ka23187/STM32F103C8T6Car/原理图等文档/原理图等文档/编码电机工作原理.pdf

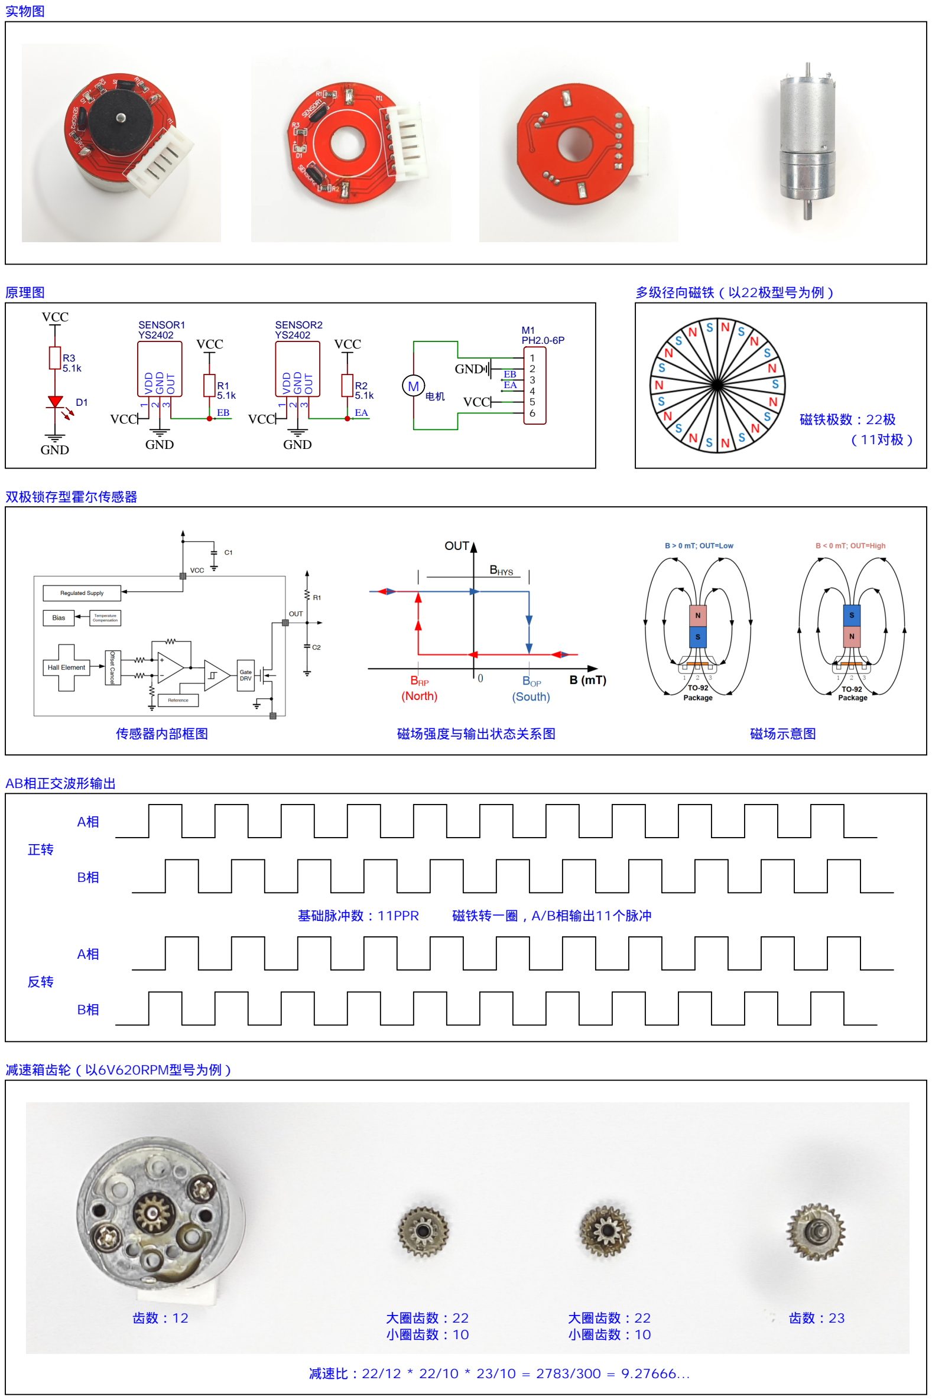
[picture p1: page 1]

PH2.0-6P

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
GND EB EA

YS2402

SENSOR1 VDD

1

GND

2

OUT

3

YS2402

SENSOR2 VDD

1

GND

2

OUT

3

5.1k

R1
5.1k

R2

5.1k

R3

D1

VCC

GND | GND | GND
VCC | VCC

VCC

EB | EA

VCC

传感器内部框图 | 磁场强度与输出状态关系图 | 磁场示意图

双极锁存型霍尔传感器

原理图 | 多级径向磁铁（以22极型号为例）

实物图

基础脉冲数：11PPR

磁铁极数：22极

A相

B相

正转

反转
B相

A相

AB相正交波形输出

磁铁转一圈，A/B相输出11个脉冲

（11对极）

减速箱齿轮（以6V620RPM型号为例）

齿数：12 | 大圈齿数：22 小圈齿数：10

大圈齿数：22
小圈齿数：10

齿数：23

减速比：22/12 * 22/10 * 23/10 = 2783/300 = 9.27666...
