ka23187/STM32F103C8T6Car/原理图等文档/原理图等文档/原理图版本说明.txt

************************************************************
平衡车控制板-V1.0
- 初始版本

平衡车控制板-V2.0
- 将单独LDO降压结构改成了DCDC+LDO串联降压结构，降低了LDO的发热

************************************************************
遥控器-V1.0
- 初始版本

遥控器-V2.0
- 增加了电源指示灯，方便观察电源状态

遥控器-V3.0
- TypeC接口增加了两个5.1kΩ电阻，支持双C口电源线充电
- 优化了天线匹配电路，信号更好
