ka23187/STM32F103C8T6Car/原理图等文档/原理图等文档/遥控器-V1.0.pdf

# ANT 10 GND 11 GND 12 DNC 13 VDD 14 GND 15 VCC 16

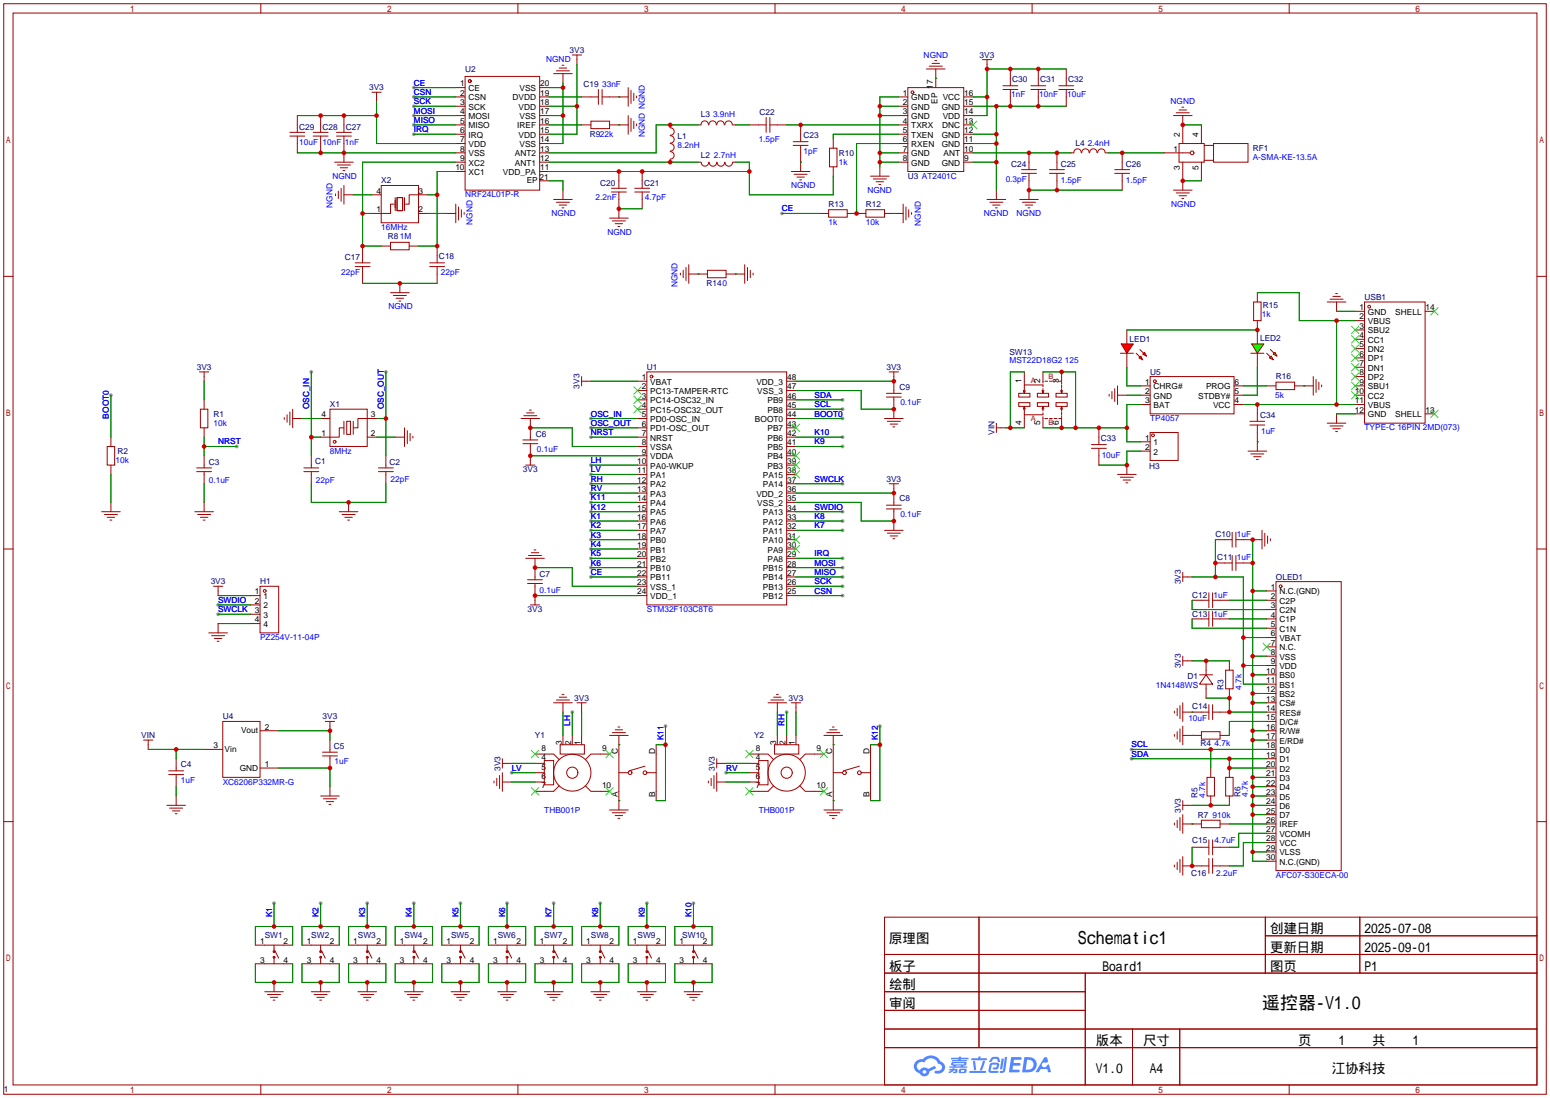
[picture p4: page 1]

原理图 | Schematic1 | 创建日期 | 2025-07-08

更新日期 | 2025-09-01

板子 | Board1 | 图页 | P1
绘制 | | 遥控器-V1.0
审阅

V1.0 | A4 | 江协科技
