ka23187/STM32F103C8T6Car/原理图等文档/原理图等文档/平衡车控制板-V1.0.pdf

# 3V3CE

## U6VIN

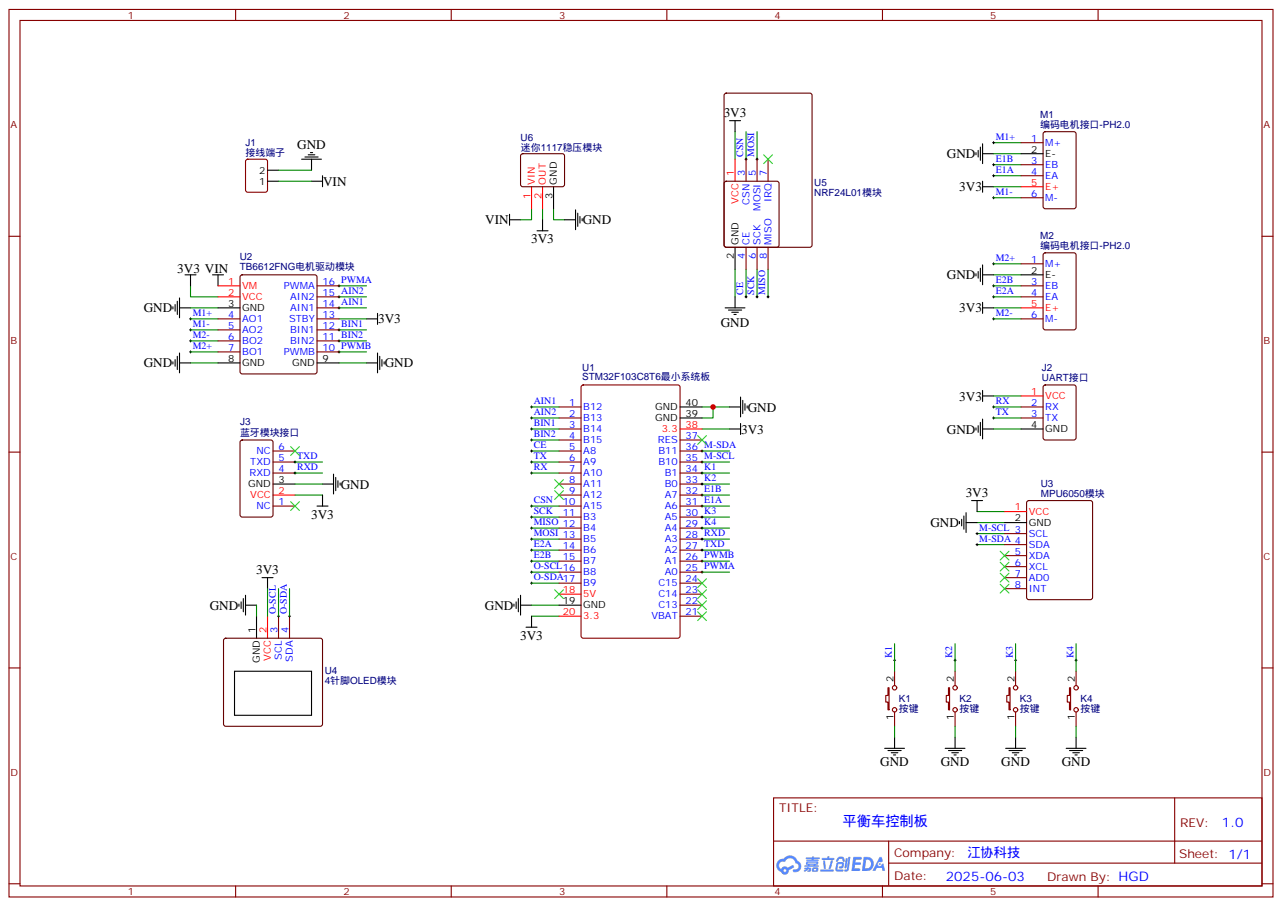
[picture p6: page 1]
