ka23187/STM32F103C8T6Car/(commit log)

2026-08-25 平衡车与遥控器
2026-09-02 增加README.md
